dietervansteenwegen/LedRingStereoscoop/Led ring stereoscope.dxf

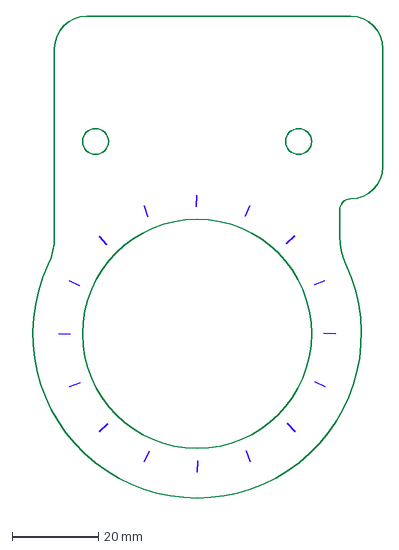
[picture p1: CAD file, 2019-12-26]
Led ring stereoscope.dxf
84.9 x 114.2 mm
