dietervansteenwegen/LedRingStereoscoop/(list of files, cad)

Other CAD files:
PCB layout.dxf
Led ring stereoscope.dwg
