dietervansteenwegen/LedRingStereoscoop/(list of files, drawings)

Other design files:
Led ring stereoscoop v0.1.dch
Led ring stereoscoop v0.2.dch
Led ring stereoscoop v0.2.dip
Led ring stereoscoop v0.3.1.dip
Led ring stereoscoop v0.3.dch
Led ring stereoscoop v0.3.dip
Led ring stereoscoop v0.b1.dip
v0.4/Led ring stereoscoop v0.4.dch
