dietervansteenwegen/LedRingStereoscoop/FW/Led_Ring_Stereoscope.X/uart.h

// This is a guard condition so that contents of this file are not included
// more than once.  
#ifndef UART_H
#define	UART_H

#include <xc.h> // include processor files - each processor file is guarded.
#include <string.h>
#include <stdlib.h>
#include "hardware.h"

void Uart1SendString(char *buffer );
void Uart1SendChar(char ch);

#ifdef	__cplusplus
extern "C" {
#endif /* __cplusplus */

    // TODO If C++ is being used, regular C code needs function names to have C 
    // linkage so the functions can be used by the c code. 

#ifdef	__cplusplus
}
#endif /* __cplusplus */

#endif	/* XC_HEADER_TEMPLATE_H */
