dietervansteenwegen/LedRingStereoscoop/(commit log)

2019-12-23 - Initial commit - Blank project for PIC24FJ128GB204 with - Uart1 - Heartbeat led - Red and Green led - TP1 - WDT
    [Led ring stereoscoop v0.1.dch, Led ring stereoscoop v0.1.dip, Led ring stereoscoop v0.2.dch, Led ring stereoscoop v0.2.dip, Led ring stereoscoop v0.3.dch, Led ring stereoscoop v0.b1.dip, Led ring stereoscope.dwg, Led ring stereoscope.dxf]
2019-12-26 Added pcb lcutout dxf and layout v0.2
    [Led ring stereoscoop v0.2.dip, Led ring stereoscope.dxf, PCB layout.dxf]
2020-01-01 Rotary encoder now works (toggles red/green LED on CCW/CW rotations) UART port works, but displays init message two times. Not sure where that comes from...
2020-01-07 Defines for battery charging pin at PORTB2
2020-01-07 Trying to get ADC to work (conversion does not start or finish)
2020-12-11 Update .gitignore, I2C1.c, and 26 more files...
2020-12-13 Update .gitignore, I2C1.c, and 14 more files...
2020-12-22 - I2C "sub address" was actually meant to be register ID. Updated.
2020-12-22 Updated I2C constants to work with I2C lib - added setAllLeds(uint8_t * pbrightness1) which takes pointer and uses auto increment to use next 16 bytes for all leds - added setGroupPWM which takes uin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
2020-12-22 - Moved interrupts to separate file - added header file for shared variables
2020-12-22 - Moved the led_start_routine to hardware.c - moved the __delay_ms import to the top (though the battery sampling probably still doesn't work :) )
    [hardware.c, hardware.h]
2020-12-22 - some updates to v0.3 of the pcb
    [Led ring stereoscoop v0.1.dip, Led ring stereoscoop v0.3.dch, Led ring stereoscoop v0.3.dip]
2020-12-22 first working version where ledring overall brightness is changed with rotary encoder. - state machine for button press - added: updateMasterBrightness, rotated, stateMachineAdvance, updateStrip - on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
2020-12-22 Update Led ring flowchart.drawio
2020-12-22 - startup led blinking was way to long
2021-01-01 v0.1. Working leds (master brightness, segment width and center)
2021-01-01 silkscreen on DC in
    [Led ring stereoscoop v0.3.dip]
2021-01-18 Update Led ring stereoscoop v0.3.dch, Led ring stereoscoop v0.3.dip, and PCB Versions.txt
    [Led ring stereoscoop v0.3.dch, Led ring stereoscoop v0.3.dip]
2021-01-18 - fixed uart tx/rx pin assignments in comments - ADC now working (initAdc wasn't called :( ) -
    [hardware.c, main.c]
2021-03-11 - v0.3 almost done
    [Led ring stereoscoop v0.2.dip, Led ring stereoscoop v0.3.1.dip, Led ring stereoscoop v0.3.dch]
2021-11-13 Most pin modifications for PCB v3.1
2022-11-26 Init FET gate
    [Led ring stereoscoop v0.3.dch]
2022-11-26 No idea what changed
    [Led ring stereoscoop v0.3.dch]
2022-11-26 v0.3 and v0.4 initial commit
    [LED Ring v0.3 BOM.csv, Led ring stereoscoop v0.4.dch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]
2022-11-26 Inductor traces
